carefreeinv/mqttpi-4-20ma/hardware/hat-4ch/ads1115-4-20ma-hat-4ch.pdf

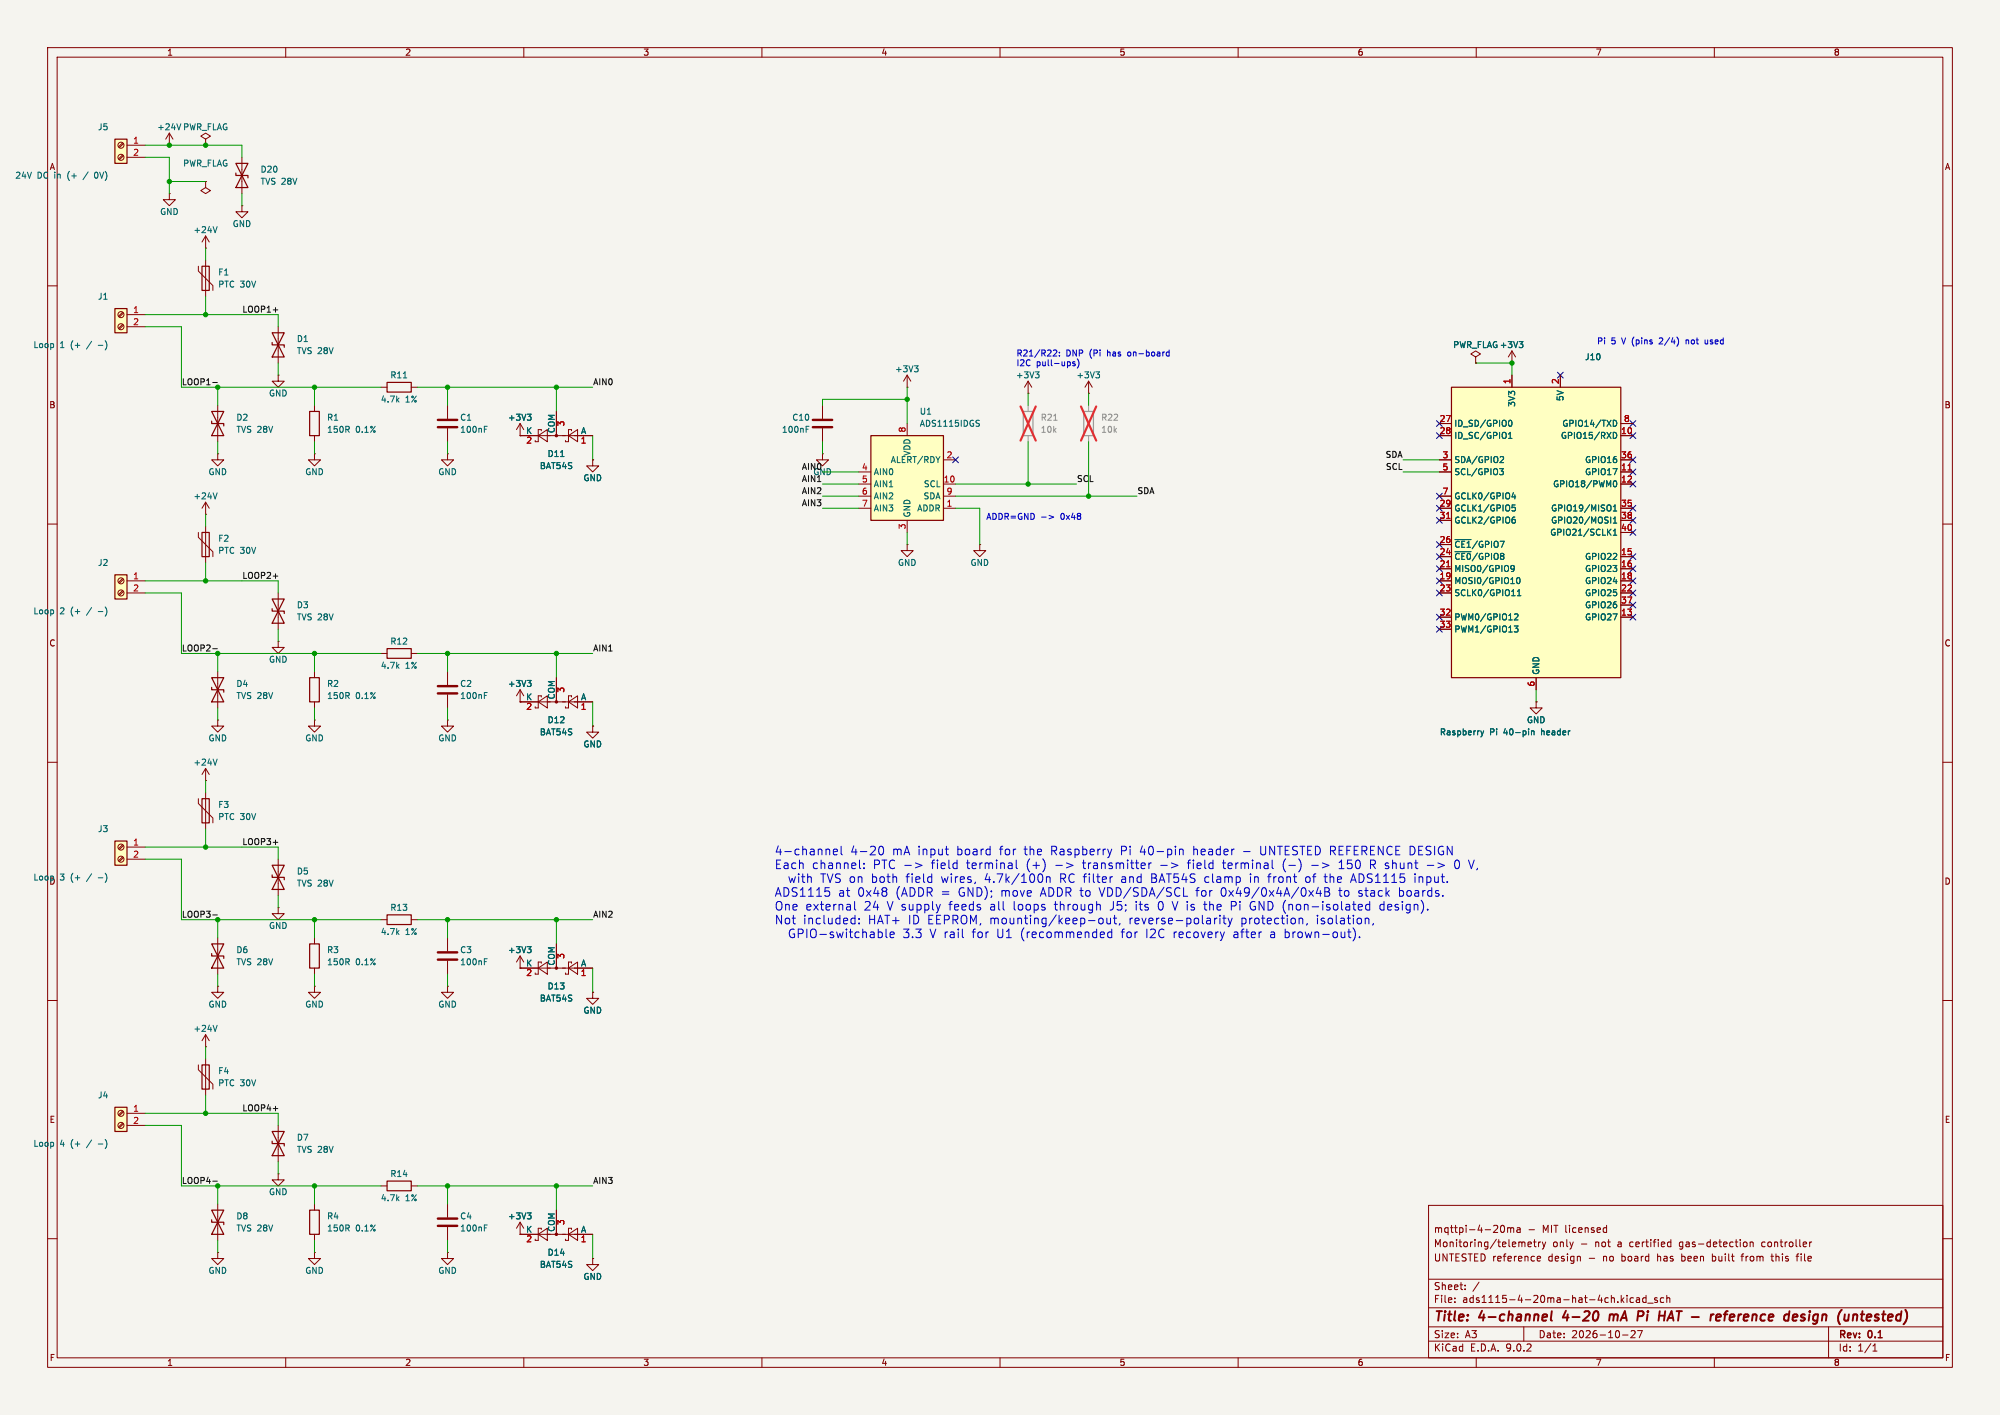
[picture p3: page 1]

3 ALERT/RDY 2 SCL 10 SDA 9 ADDR 1 U1ADS1115IDGS
