carefreeinv/mqttpi-4-20ma/hardware/single-channel/ads1115-4-20ma-single.pdf

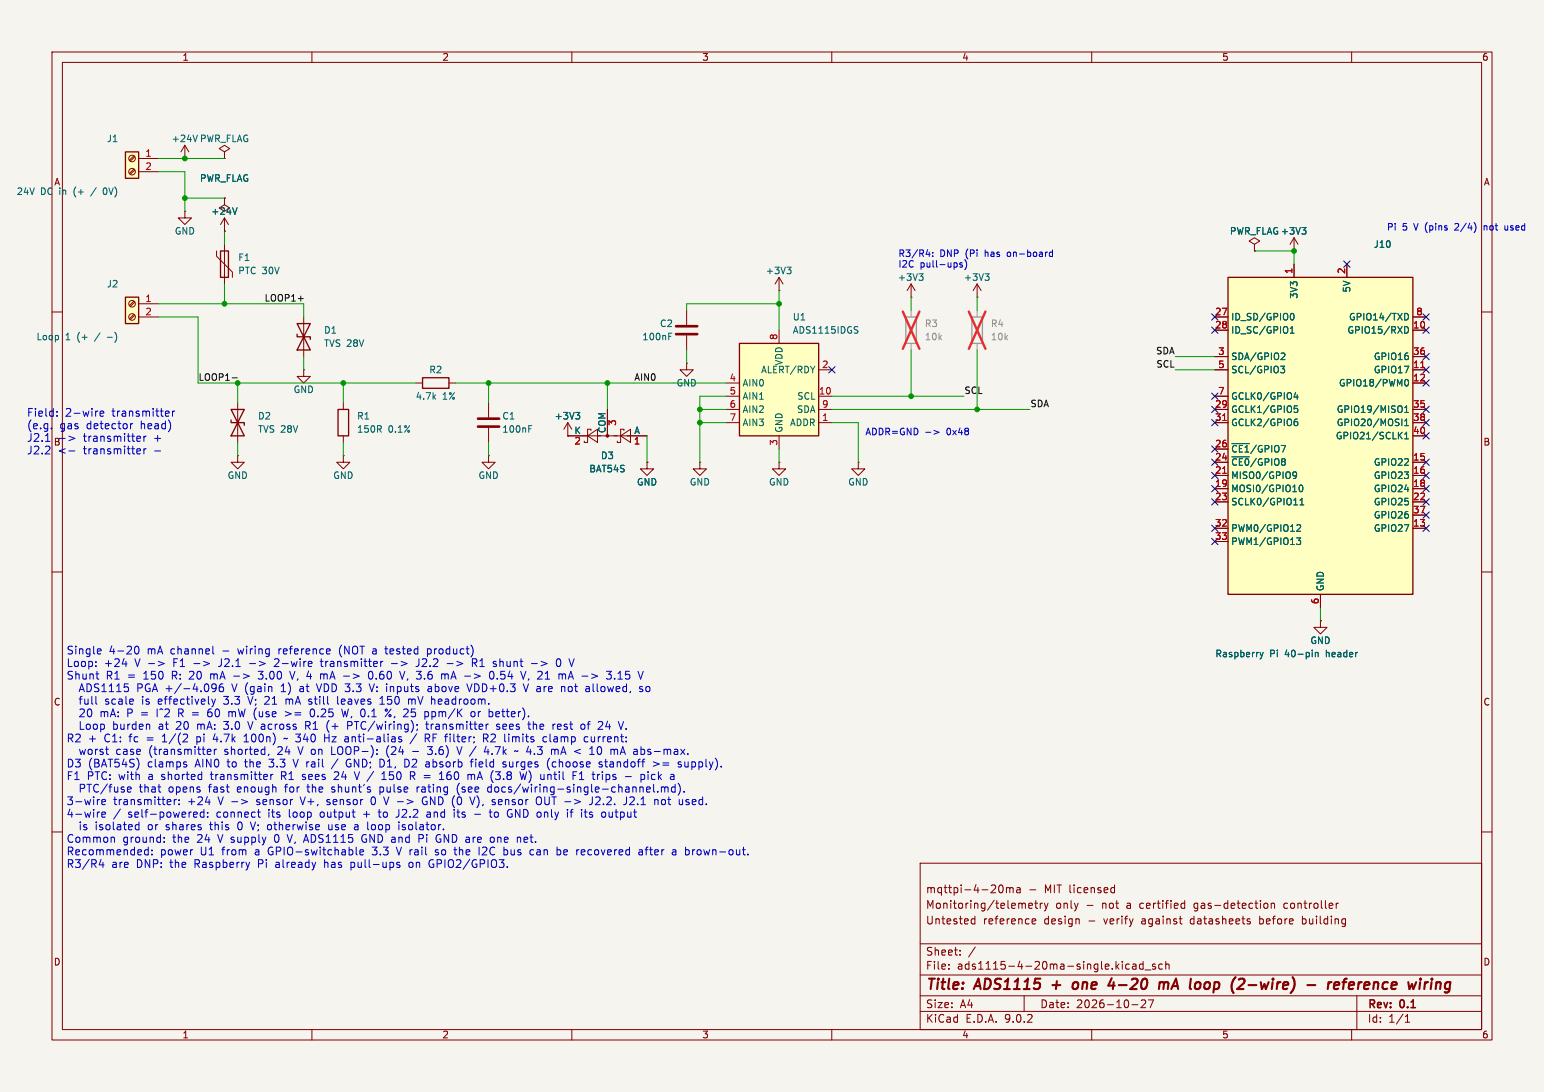
[picture p4: page 1]

3 ALERT/RDY 2 SCL 10 SDA 9 ADDR 1 U1ADS1115IDGSGND
