carefreeinv/mqttpi-4-20ma/hardware/hat-4ch/ads1115-4-20ma-hat-4ch.kicad_sch

## KiCad design hardware/hat-4ch/ads1115-4-20ma-hat-4ch.kicad_sch (2026-10-27)

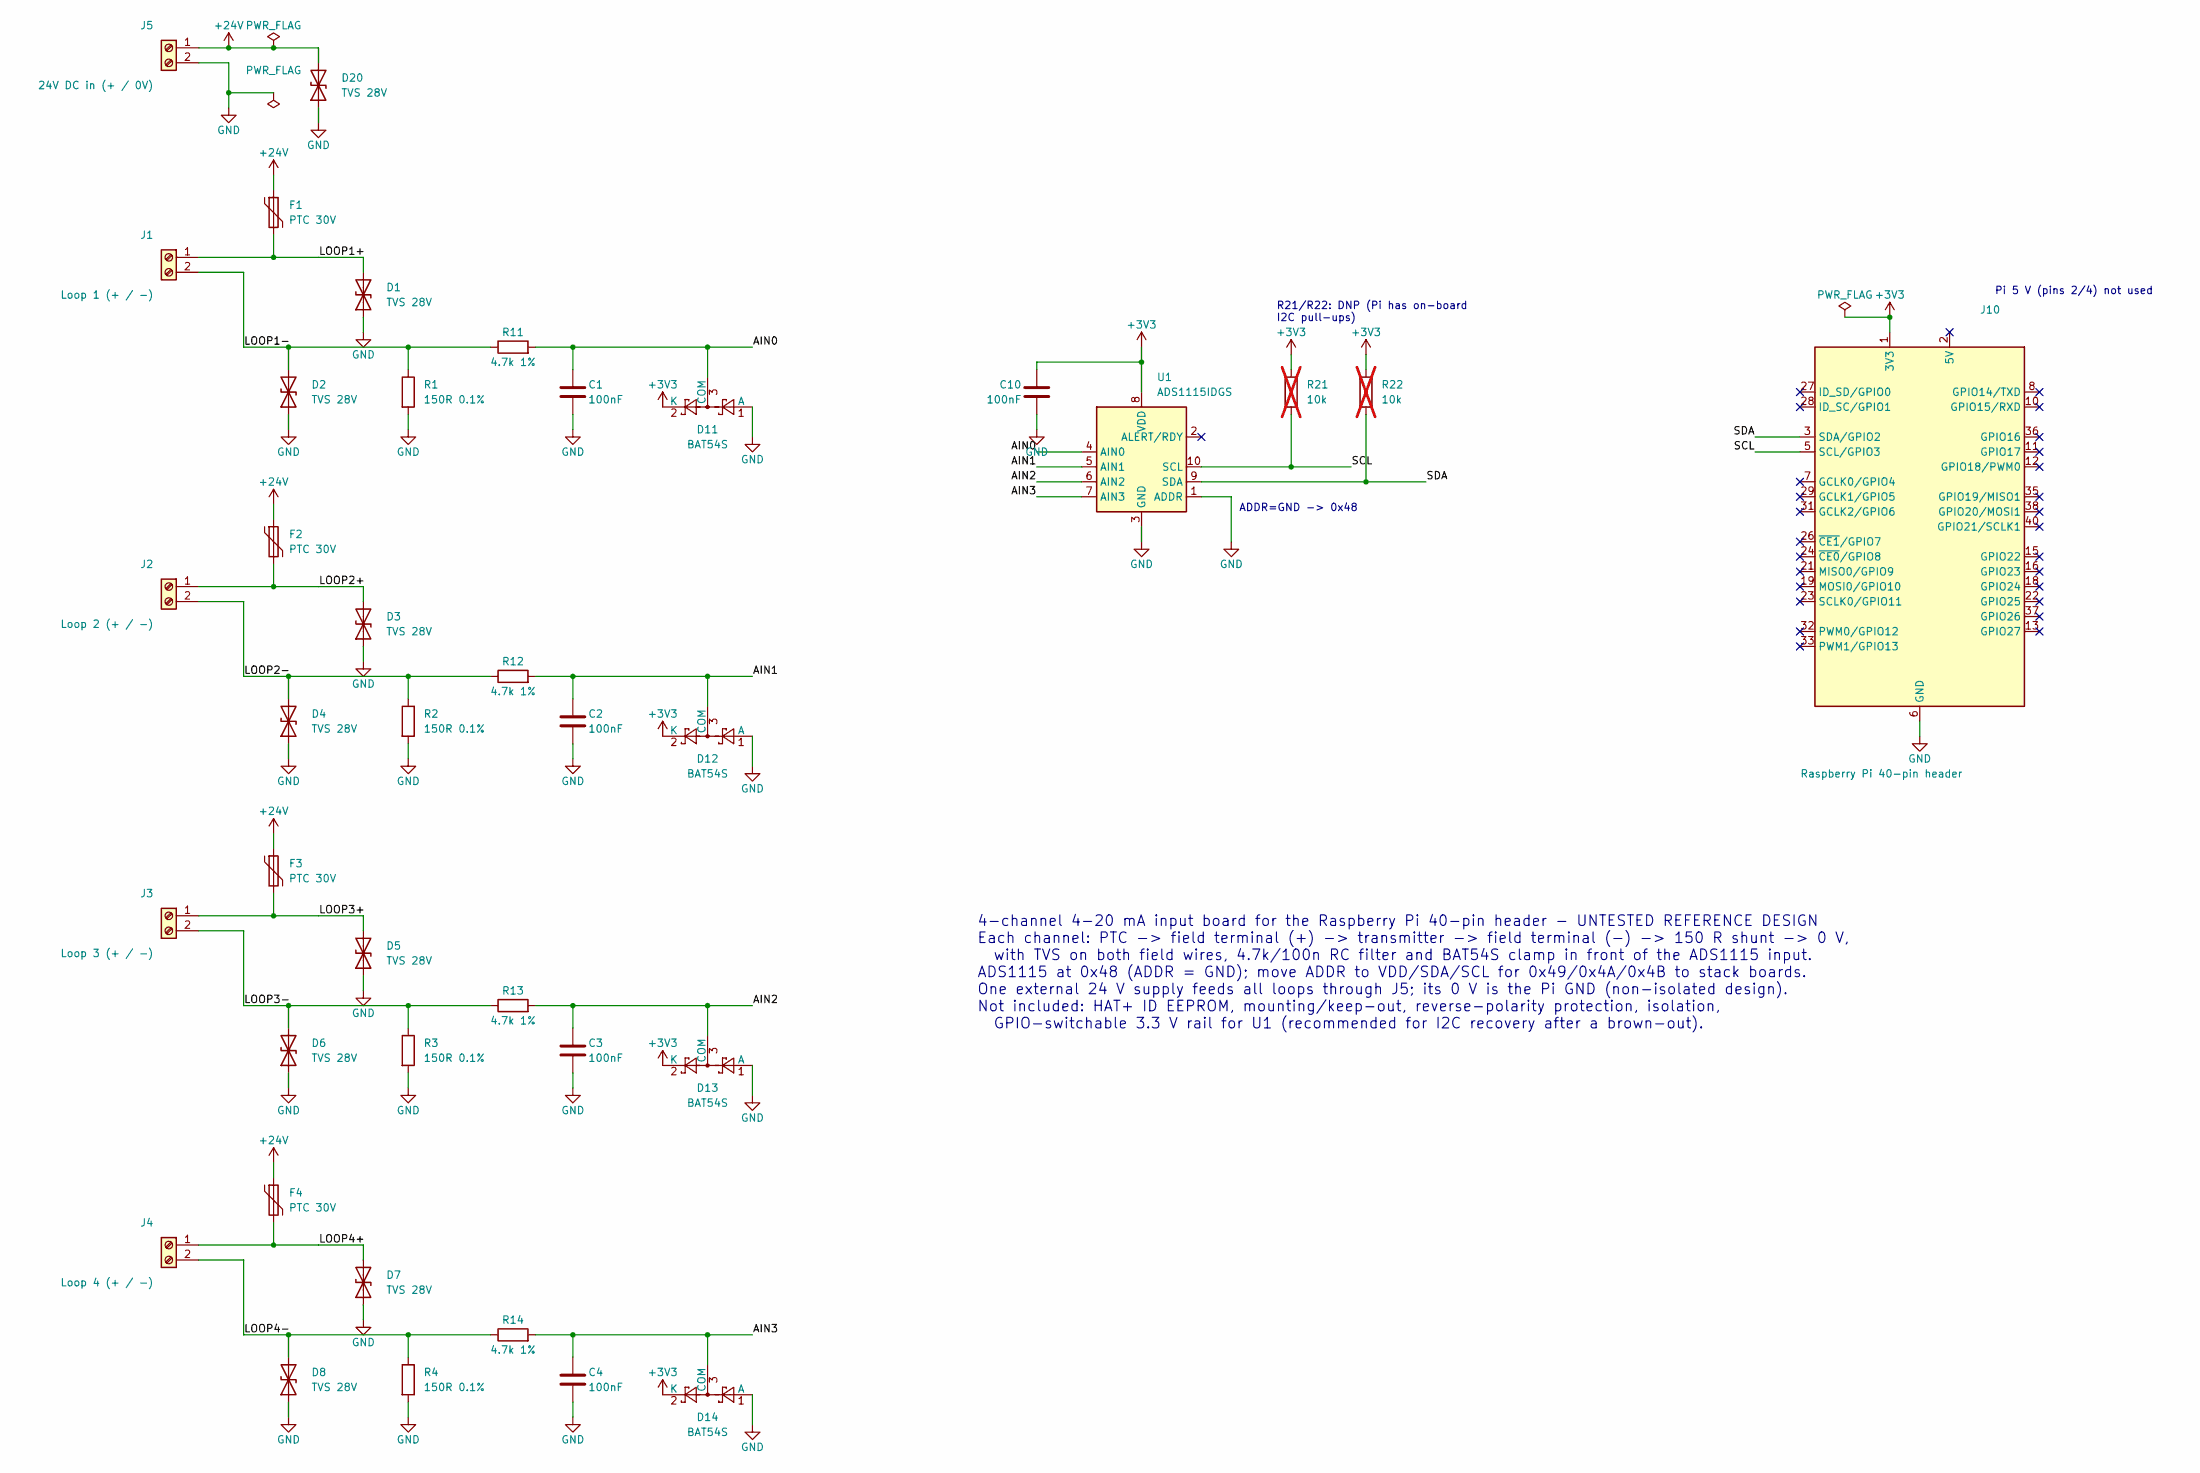
[picture p5: schematic ads1115-4-20ma-hat-4ch.kicad_sch]

Parts:
C1, C2, C3, C4, C10: 100nF; C_0603_1608Metric
D1, D2, D3, D4, D5, D6, D7, D8, D20: TVS 28V; D_SMB
D11, D12, D13, D14: BAT54S; SOT-23
F1, F2, F3, F4: PTC 30V; Fuse_1206_3216Metric
J1: Loop 1 (+ / -); TerminalBlock_Phoenix_MKDS-1,5-2-5.08_1x02_P5.08mm_Horizont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
J2: Loop 2 (+ / -); TerminalBlock_Phoenix_MKDS-1,5-2-5.08_1x02_P5.08mm_Horizont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
J3: Loop 3 (+ / -); TerminalBlock_Phoenix_MKDS-1,5-2-5.08_1x02_P5.08mm_Horizont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
J4: Loop 4 (+ / -); TerminalBlock_Phoenix_MKDS-1,5-2-5.08_1x02_P5.08mm_Horizont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
J5: 24V DC in (+ / 0V); TerminalBlock_Phoenix_MKDS-1,5-2-5.08_1x02_P5.08mm_Horizont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
J10: Raspberry Pi 40-pin header; PinSocket_2x20_P2.54mm_Vertical
R1, R2, R3, R4: 150R 0.1%; R_1206_3216Metric
R11, R12, R13, R14: 4.7k 1%; R_0603_1608Metric
R21, R22: 10k; R_0603_1608Metric; not fitted
U1: ADS1115IDGS; TSSOP-10_3x3mm_P0.5mm

Connections:
+3V3: C10.1, D11.2 (K), D12.2 (K), D13.2 (K), D14.2 (K), J10.1 (3V3), J10.17 (3V3), R21.1, R22.1, U1.8 (VDD)
+24V: D20.2 (A2), F1.1, F2.1, F3.1, F4.1, J5.1
AIN0: C1.1, D11.3 (COM), R11.2, U1.4 (AIN0)
AIN1: C2.1, D12.3 (COM), R12.2, U1.5 (AIN1)
AIN2: C3.1, D13.3 (COM), R13.2, U1.6 (AIN2)
AIN3: C4.1, D14.3 (COM), R14.2, U1.7 (AIN3)
GND: C1.2, C2.2, C3.2, C4.2, C10.2, D1.1 (A1), D2.1 (A1), D3.1 (A1), D4.1 (A1), D5.1 (A1), D6.1 (A1), D7.1 (A1), D8.1 (A1), D11.1 (A), D12.1 (A), D13.1 (A), D14.1 (A), D20.1 (A1), J5.2, J10.6 (GND), J10.9 (GND), J10.14 (GND), J10.20 (GND), J10.25 (GND), J10.30 (GND), J10.34 (GND), J10.39 (GND), R1.2, R2.2, R3.2, R4.2, U1.1 (ADDR), U1.3 (GND)
LOOP1+: D1.2 (A2), F1.2, J1.1
LOOP1-: D2.2 (A2), J1.2, R1.1, R11.1
LOOP2+: D3.2 (A2), F2.2, J2.1
LOOP2-: D4.2 (A2), J2.2, R2.1, R12.1
LOOP3+: D5.2 (A2), F3.2, J3.1
LOOP3-: D6.2 (A2), J3.2, R3.1, R13.1
LOOP4+: D7.2 (A2), F4.2, J4.1
LOOP4-: D8.2 (A2), J4.2, R4.1, R14.1
unnamed: J10.2 (5V), J10.4 (5V)
SCL: J10.5 (SCL/GPIO3), R21.2, U1.10 (SCL)
SDA: J10.3 (SDA/GPIO2), R22.2, U1.9 (SDA)

Notes on the sheet:
ADDR=GND -> 0x48
R21/R22: DNP (Pi has on-board I2C pull-ups)
Pi 5 V (pins 2/4) not used
4-channel 4-20 mA input board for the Raspberry Pi 40-pin header - UNTESTED REFERENCE DESIGN Each channel: PTC -> field terminal (+) -> transmitter -> field terminal (-) -> 150 R shunt -> 0 V, with TVS on both field wires, 4.7k/100n RC filter and BAT54S clamp in front of the ADS1115 input. ADS1115 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
