carefreeinv/mqttpi-4-20ma/hardware/single-channel/ads1115-4-20ma-single.kicad_sch

## KiCad design hardware/single-channel/ads1115-4-20ma-single.kicad_sch (2026-10-27)

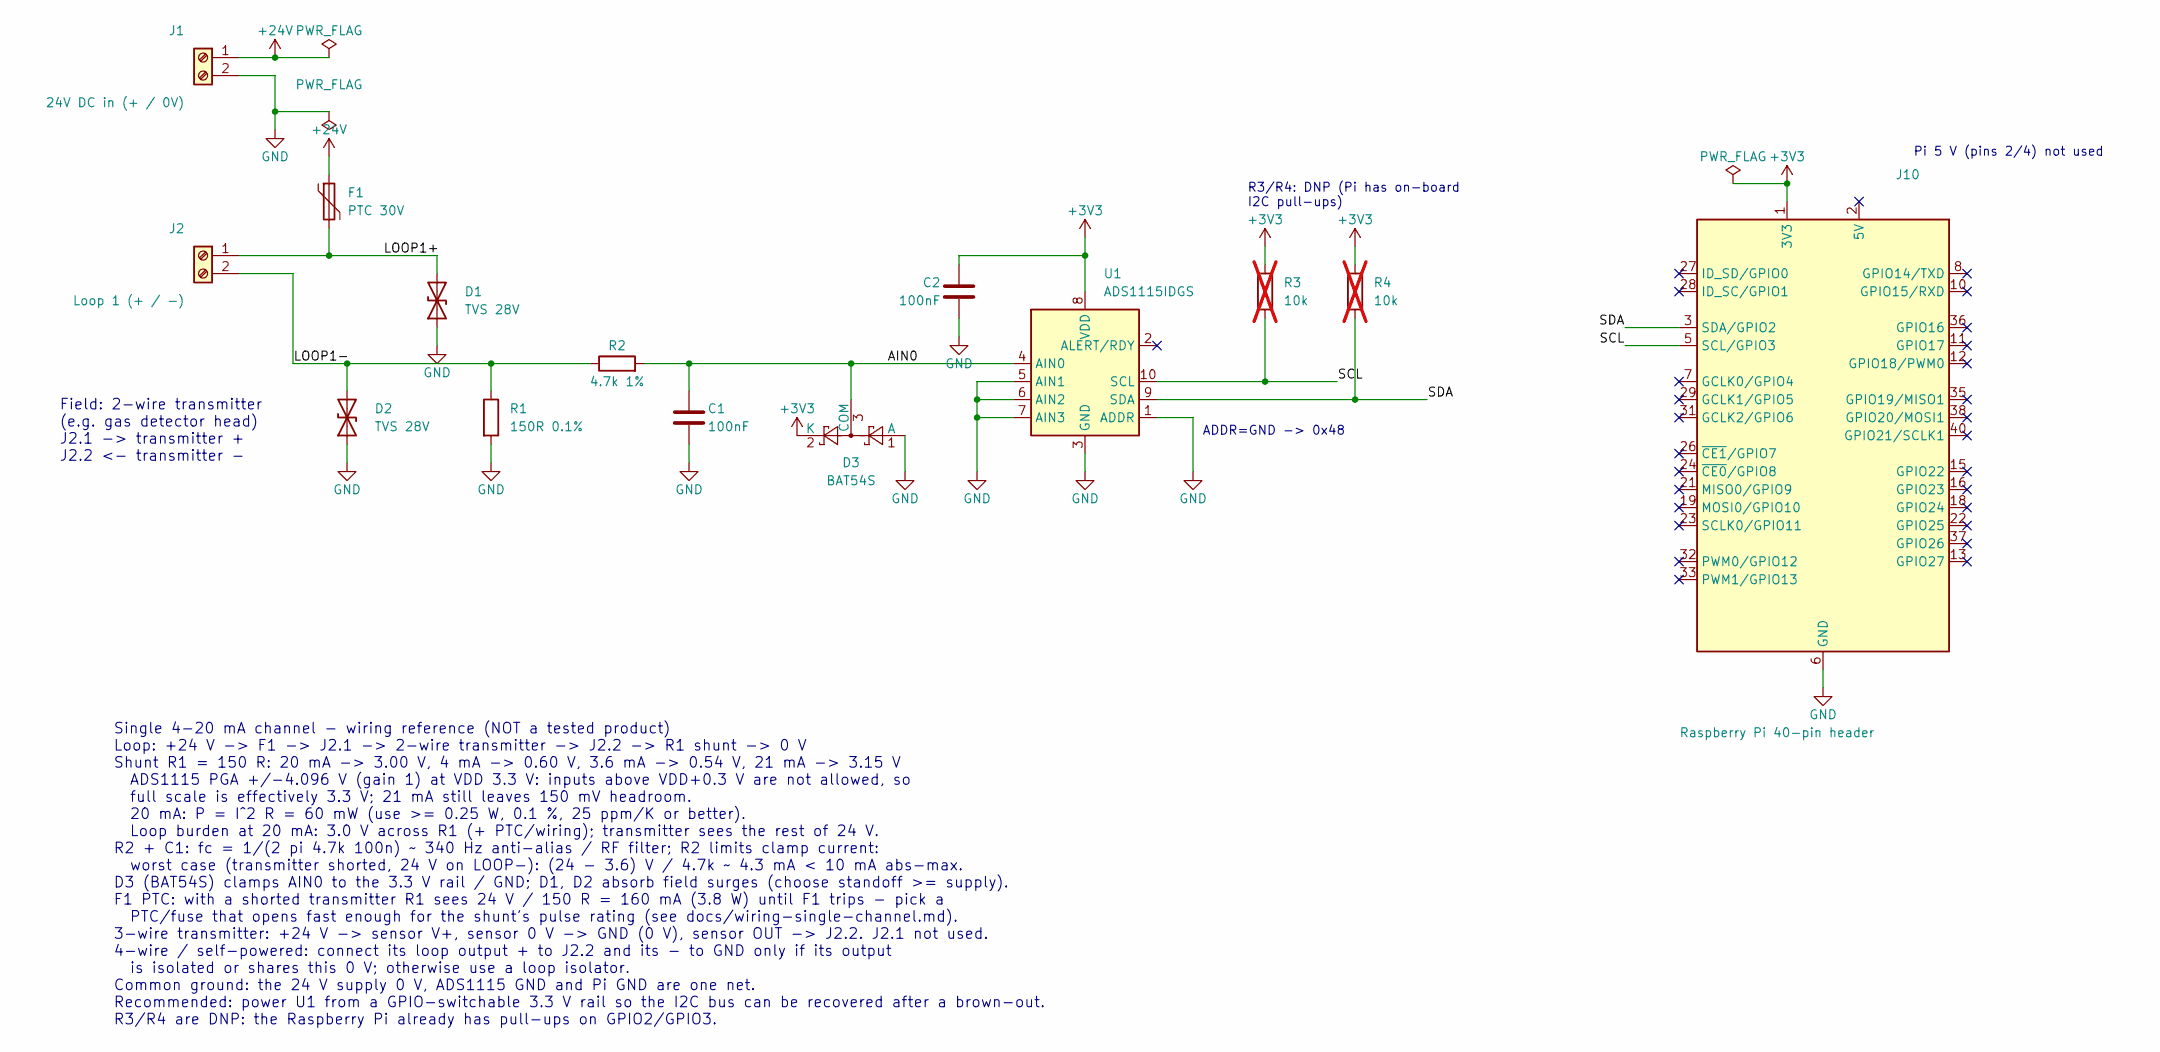
[picture p6: schematic ads1115-4-20ma-single.kicad_sch]

Parts:
C1, C2: 100nF; C_0603_1608Metric
D1, D2: TVS 28V; D_SMB
D3: BAT54S; SOT-23
F1: PTC 30V; Fuse_1206_3216Metric
J1: 24V DC in (+ / 0V); TerminalBlock_Phoenix_MKDS-1,5-2-5.08_1x02_P5.08mm_Horizont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
J2: Loop 1 (+ / -); TerminalBlock_Phoenix_MKDS-1,5-2-5.08_1x02_P5.08mm_Horizont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
J10: Raspberry Pi 40-pin header; PinSocket_2x20_P2.54mm_Vertical
R1: 150R 0.1%; R_1206_3216Metric
R2: 4.7k 1%; R_0603_1608Metric
R3, R4: 10k; R_0603_1608Metric; not fitted
U1: ADS1115IDGS; TSSOP-10_3x3mm_P0.5mm

Connections:
+3V3: C2.1, D3.2 (K), J10.1 (3V3), J10.17 (3V3), R3.1, R4.1, U1.8 (VDD)
+24V: F1.1, J1.1
AIN0: C1.1, D3.3 (COM), R2.2, U1.4 (AIN0)
GND: C1.2, C2.2, D1.1 (A1), D2.1 (A1), D3.1 (A), J1.2, J10.6 (GND), J10.9 (GND), J10.14 (GND), J10.20 (GND), J10.25 (GND), J10.30 (GND), J10.34 (GND), J10.39 (GND), R1.2, U1.1 (ADDR), U1.3 (GND), U1.5 (AIN1), U1.6 (AIN2), U1.7 (AIN3)
LOOP1+: D1.2 (A2), F1.2, J2.1
LOOP1-: D2.2 (A2), J2.2, R1.1, R2.1
unnamed: J10.2 (5V), J10.4 (5V)
SCL: J10.5 (SCL/GPIO3), R3.2, U1.10 (SCL)
SDA: J10.3 (SDA/GPIO2), R4.2, U1.9 (SDA)

Notes on the sheet:
Field: 2-wire transmitter (e.g. gas detector head) J2.1 -> transmitter + J2.2 <- transmitter -
ADDR=GND -> 0x48
R3/R4: DNP (Pi has on-board I2C pull-ups)
Pi 5 V (pins 2/4) not used
Single 4-20 mA channel - wiring reference (NOT a tested product) Loop: +24 V -> F1 -> J2.1 -> 2-wire transmitter -> J2.2 -> R1 shunt -> 0 V Shunt R1 = 150 R: 20 mA -> 3.00 V, 4 mA -> 0.60 V, 3.6 mA -> 0.54 V, 21 mA -> 3.15 V ADS1115 PGA +/-4.096 V (gain 1) at VDD 3.3 V: inputs above VDD+0.3 V are n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
